hiro-otsuka/AVR_MusicBox/circuits/CIRCUITS_MB.jpg

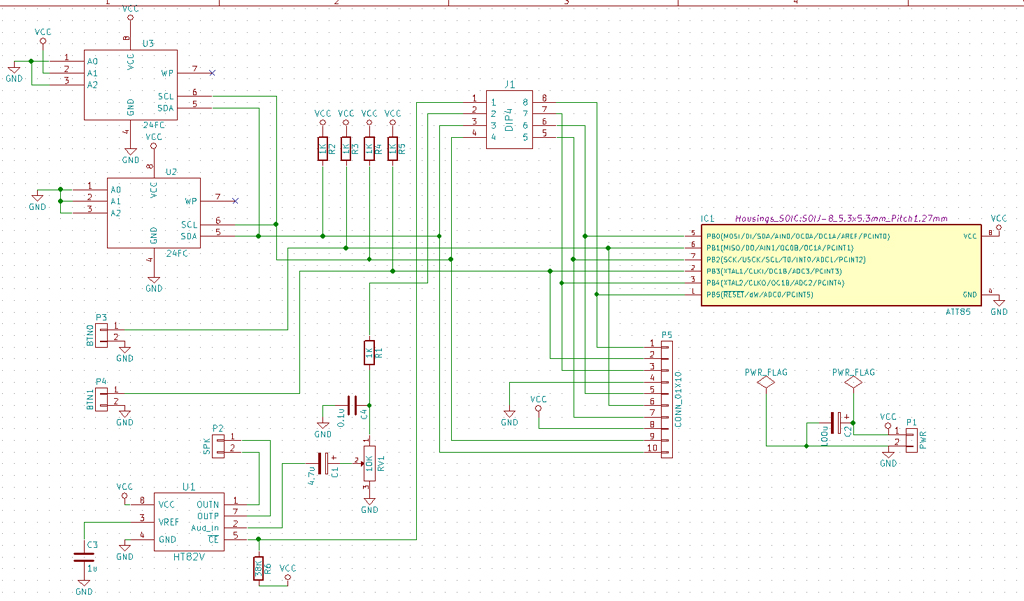
circuits/CIRCUITS_MB.jpg
