hiro-otsuka/AVR_MusicBox/circuits/CIRCUITS_Writer.jpg

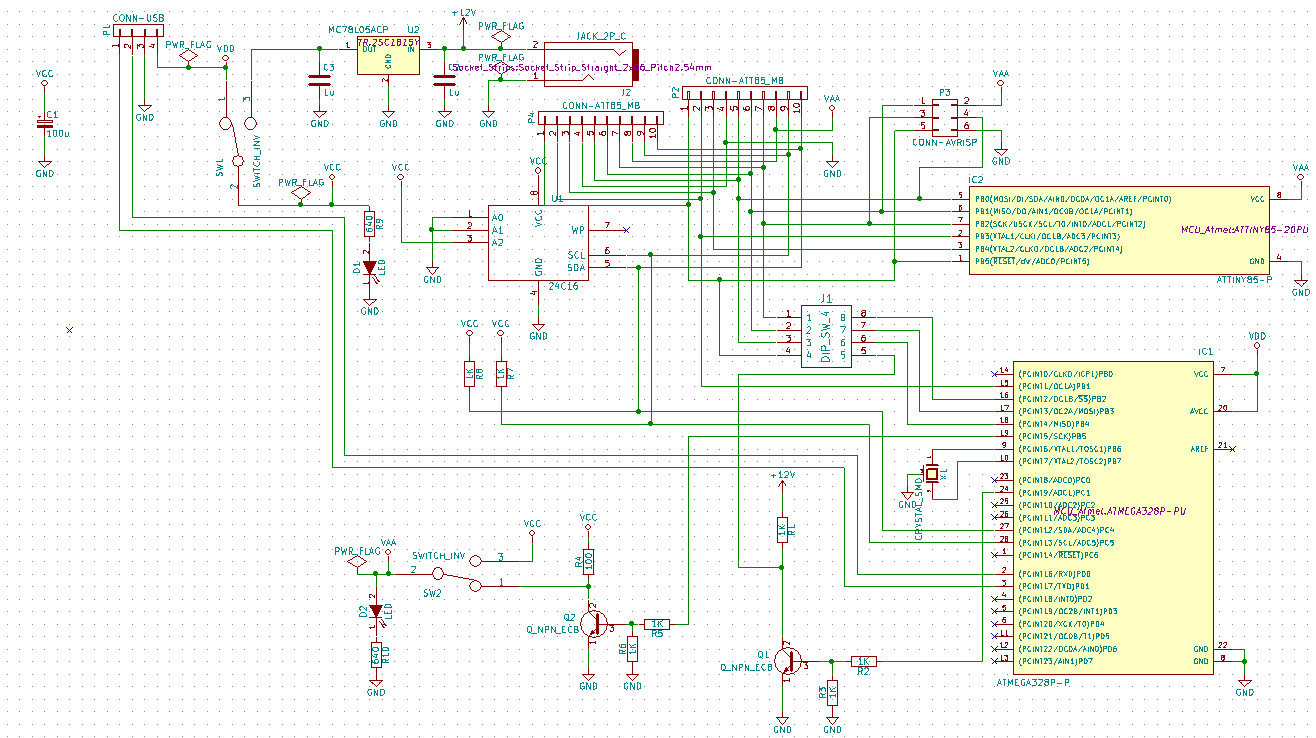
circuits/CIRCUITS_Writer.jpg
