hiro-otsuka/AVR_MusicBox/(commit log)

2017-02-17 ソース登録
    公開版ソースを登録
2017-02-17 README にリンクを追加
2017-02-17 README のリンクを修正
2017-02-17 README を修正
2017-02-17 READMEを更新
2017-02-17 README を更新
2017-02-17 ドキュメントを修正
2017-02-18 MMLの仕様拡張、波形の追加
    ・MMLにサブパート定義とループ定義を追加
    ・波形に鋸波を追加
2017-02-18 ドキュメントの改善
2017-02-18 MMLの仕様拡張、波形の追加
2017-02-19 MMLの改善
2017-02-19 周波数変更時のプチノイズを改善
2017-02-23 MMLとWAVを分離して再生できるよう改善
2017-02-24 シリアル通信で再生番号を指定するサンプルを追加
2017-02-28 Init 実行時にEEPROMからパラメータを読み込む機能を追加
2017-03-11 GUI連携および64bit版バイナリを登録
2017-03-12 回路図およびドキュメントを仮整備
2017-03-12 ドキュメントの誤りを修正
2017-03-22 回路図例の更新およびMML2BINの利便性向上
2017-03-25 チャンネル数による音量制限を廃止しMMLで調整するよう変更
2017-04-01 IMA-ADPCMの再生機能追加および複数EEPROMをリニアに扱うよう機能変更
2017-04-04 バグ修正
2017-04-09 PUIプログラムの追加および再生方法をパラメータ化
2017-04-10 本体のバグ修正＆PUIの機能変更
2017-04-16 パラメータ記述テキストの変換ツールを追加
2017-04-24 マイコン内蔵のEEPROMで動作モードやプルアップ要否を指定するよう変更
2017-04-29 バグ修正＆シリアル通信モードの2動作をパラメータで統合
2017-05-07 ボタン番号指定とパラレル指定のモードを追加
2017-05-13 ピンのI/O設定を内蔵EEPROMで指定できるよう変更
2017-05-15 プログラムの変更に合わせてドキュメントを改訂
2017-05-15 実行ファイルやパラメータファイルの公開方法を変更
2017-05-19 多ピンマイコンのコードサイズを縮小、出力ピン設定時の動作を整備
2017-05-19 ピン入出力コマンドのバグを修正
2017-05-22 GUIの整備に伴い若干の修正を実施
